Vinicius-b-oliveira/server-temperature-monitor/firmware/monitor/pins.h

// Pinos do projeto, iguais no Wokwi e na bancada
#pragma once

const int PIN_DHT = 4;
const int PIN_DS18B20 = 16;
const int PIN_BUZZER = 18;
const int PIN_FAN = 19;
const int PIN_LED_RED = 25;
const int PIN_LED_GREEN = 26;
const int PIN_BUTTON = 27;
const int PIN_LED_BLUE = 33;
const int PIN_LDR = 34;
