Vinicius-b-oliveira/server-temperature-monitor/firmware/wifi_check/wifi_check.ino

// Teste de rede: conecta ao Wi-Fi e verifica se o broker MQTT responde na porta 1883.
#include <WiFi.h>
#include <HTTPClient.h>
#include "config.h"

const unsigned long WIFI_TIMEOUT_MS = 20000;
const unsigned long TEST_INTERVAL_MS = 10000;
const int32_t TCP_TIMEOUT_MS = 5000;

unsigned long lastTestMs = 0;
int testCount = 0;

bool connectWifi() {
  Serial.println("Connecting to Wi-Fi");
  WiFi.mode(WIFI_STA);
  WiFi.begin(WIFI_SSID, WIFI_PASSWORD);

  unsigned long start = millis();
  while (WiFi.status() != WL_CONNECTED && millis() - start < WIFI_TIMEOUT_MS) {
    delay(500);
    Serial.print(".");
  }
  Serial.println();

  if (WiFi.status() != WL_CONNECTED) {
    Serial.printf("Wi-Fi failed, status %d\n", WiFi.status());
    return false;
  }
  Serial.printf("Wi-Fi connected in %lu ms\n", millis() - start);
  Serial.print("IP: ");
  Serial.println(WiFi.localIP());
  Serial.print("Gateway: ");
  Serial.println(WiFi.gatewayIP());
  return true;
}

bool testTcp(const char* host, uint16_t port) {
  IPAddress ip;
  if (!WiFi.hostByName(host, ip)) {
    Serial.printf("DNS %s failed\n", host);
    return false;
  }

  WiFiClient client;
  unsigned long start = millis();
  bool ok = client.connect(ip, port, TCP_TIMEOUT_MS);
  Serial.printf("TCP %s (%s):%u %s in %lu ms\n", host, ip.toString().c_str(), port,
                ok ? "OK" : "FAILED", millis() - start);
  client.stop();
  return ok;
}

// 204: internet livre. Outro código HTTP: portal de login. Negativo: sem internet
int checkInternet() {
  HTTPClient http;
  http.setTimeout(TCP_TIMEOUT_MS);
  http.begin(INTERNET_CHECK_URL);
  int code = http.GET();
  http.end();
  Serial.printf("HTTP %s -> %d\n", INTERNET_CHECK_URL, code);
  return code;
}

void runTests() {
  testCount++;
  Serial.printf("\nTest %d, uptime %lu s\n", testCount, millis() / 1000);

  if (WiFi.status() != WL_CONNECTED) {
    Serial.println("Wi-Fi lost, reconnecting");
    if (!connectWifi()) {
      return;
    }
  }
  Serial.printf("RSSI: %d dBm\n", WiFi.RSSI());

  bool primaryOk = testTcp(MQTT_HOST, MQTT_PORT);
  bool backupOk = testTcp(MQTT_BACKUP_HOST, MQTT_PORT);

  if (primaryOk || backupOk) {
    Serial.println("Result: MQTT port reachable");
    return;
  }

  // Sem broker: descobre se é porta bloqueada, portal ou sem internet
  int code = checkInternet();
  if (code == 204) {
    Serial.println("Result: internet OK, port 1883 blocked");
  } else if (code > 0) {
    Serial.println("Result: captive portal, network needs login in a browser");
  } else {
    Serial.println("Result: no internet access");
  }
}

void setup() {
  Serial.begin(115200);
  delay(500);
  Serial.print("\nwifi_check on ");
  Serial.println(DEVICE_ID);

  connectWifi();
  runTests();
  lastTestMs = millis();
}

void loop() {
  if (millis() - lastTestMs >= TEST_INTERVAL_MS) {
    lastTestMs = millis();
    runTests();
  }
}
