Vinicius-b-oliveira/server-temperature-monitor/(commit log)

2026-11-05 chore: cria estrutura inicial com teste de Wi-Fi
2026-11-05 feat: trata rede aberta e portal de login no teste de Wi-Fi
2026-11-06 feat: adiciona circuito no Wokwi e sketch de teste de hardware
2026-11-06 refactor: reorganiza os comentários dos sketches de teste
2026-11-06 docs: corrige descrições do README e do teste de Wi-Fi
    [wifi_check.ino]
2026-11-10 feat: atualiza o circuito do Wokwi para a versão final
2026-11-12 feat: põe o DHT e o LED da ventoinha na protoboard do Wokwi
2026-11-12 fix: liga o GND do LDR do Wokwi na coluna 28
